gcw427/USBPhy-RW/README.md

# USBPhy-RW
The git repo contains three folders.

USBPhy-RW-Hardware folder is dongle harware pcb project including sch/layout.by AD17

USBPhy-RW-MCUFWSRC folder is dongle STM32 MCU firmware source project.by ARM MDK.

USBPhy-RW-DOTNETSRC folder is PC software source project.by Visual Studio2015/.NetFrameWork4
