gcw427/USBPhy-RW/USBPhy-RW-HardWare/USBPhyRW/sch.pdf

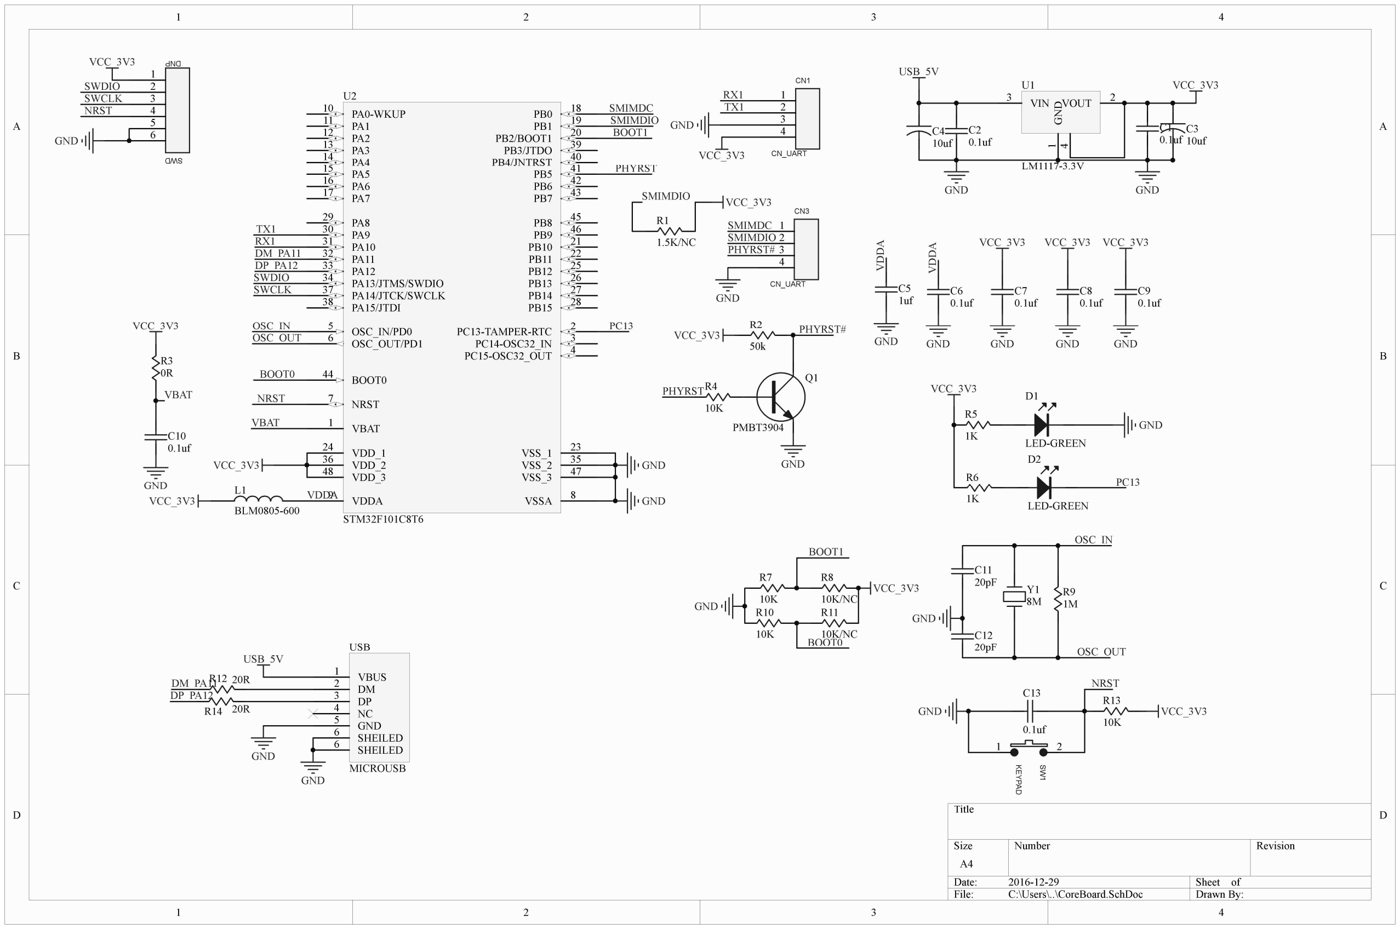
[picture p1: page 1]

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
Title
Size | Number | Revision
A4
Date: | 2016-12-29 | Sheet of
File: | C:\Users\..\CoreBoard.SchDoc | Drawn By:

BOOT0 44
NRST 7

OSC_IN/PD0 5
OSC_OUT/PD1 6

PA0-WKUP 10
PA1 11
PA2 12
PA3 13
PA4 14
PA5 15
PA6 16
PA7 17
PA8 29
PA9 30
PA10 31
PA11 32
PA12 33
PA13/JTMS/SWDIO 34
PA14/JTCK/SWCLK 37
PA15/JTDI 38

PB0 18
PB1 19
PB2/BOOT1 20
PB3/JTDO 39
PB4/JNTRST 40
PB5 41
PB6 42
PB7 43
PB8 45
PB9 46
PB10 21
PB11 22
PB12 25
PB13 26
PB14 27
PB15 28
PC13-TAMPER-RTC 2
PC14-OSC32_IN 3
PC15-OSC32_OUT 4

VBAT 1
VDD_1 24
VDD_2 36
VDD_3 48
VDDA 9

VSS_1 23
VSS_2 35
VSS_3 47
VSSA 8

U2

STM32F101C8T6

VIN 3 GND

1

VOUT 2 4

U1

LM1117-3.3V

USB_5V
VCC_3V3

C2
0.1uf

C4
10uf

C1
0.1uf

C3
10uf
GND | GND

C9
0.1uf

C8
0.1uf

C7
0.1uf

C6
0.1uf

VCC_3V3 VCC_3V3 VCC_3V3

GND | GND | GND | GND

D1

| | LED-GREEN
D2
| | LED-GREEN

Y1
8M

C11
20pF

C12
20pF

R5
1K
R6
1K

GND

VCC_3V3

GND

R9
1M
1 | 2 KEYPAD | SW1

C13
0.1uf

VCC_3V3

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
10K/NC
R10
10K

R11
10K/NC

VCC_3V3
GND

VBAT

NRST

BOOT0

OSC_IN
OSC_OUT

PC13

BOOT1

OSC_IN

OSC_OUT
NRST

PC13

BOOT0

BOOT1

C5
1uf
GND

VCC_3V3

R3
0R
VBAT
C10
0.1uf

VCC_3V3

GND

1
2
3
4

CN1

CN_UART

1
2
3
4
5

### 6 SWD

RX1
TX1
GND
VCC_3V3

RX1

TX1

VCC_3V3

GND

SWDIO
SWCLK

SWDIO
SWCLK
NRST

1
2
3
4

CN3

CN_UART

SMIMDC
SMIMDIO

SMIMDC
SMIMDIO

VBUS 1
DM 2
DP 3
NC 4
GND 5
SHEILED 6
SHEILED 6

USB

MICROUSB

GND

USB_5V

PHYRST

GND

Q1

PMBT3904

R4
10K

VCC_3V3

R2
50k

PHYRST

GND

PHYRST#

PHYRST#

R12 20R
R14 20R

DM_PA11
DP_PA12

DM_PA11
DP_PA12

GND

L1
BLM0805-600
VCC_3V3 | VDDA | VDDA | VDDA

R1
1.5K/NC

SMIMDIO VCC_3V3
