gcw427/USBPhy-RW/USBPhy-RW-HardWare/USBPhyRW/USBPhyRW.xlsx

Comment | Description | Designator | Footprint | LibRef | Quantity
0.1uf | Capacitor | C1, C2, C6, C7, C8, C9, C10, C13 | C0603 | CAP_1 | 8
10uf | Capacitor | C3, C4 | SMD-CT-2012 | CAPACITOR | 2
1uf | Capacitor | C5 | C0603 | CAP_1 | 1
20pF | Capacitor | C11, C12 | C0603 | CAP | 2
CN_UART |  | CN3 | CON_SIP4BOX_2MM | CON4 | 1 | 不贴
LED-GREEN |  | D1, D2 | LED-0805 | LED | 2
1.5K/NC |  | R1 | R0603 | RES1 | 1 | 不贴
50k/NC |  | R2 | R0603 | RES1 | 1 | 不贴
0R/NC |  | R3 | R0603 | RES1 | 1 | 不贴
0R |  | R4, R16 | R0603 | RES1, INDUCTOR1 | 2
1K |  | R5, R6 | R0603 | RES1 | 2
10K |  | R7, R10, R13 | R0603 | RES1 | 3
10K/NC |  | R8, R11 | R0603 | RES1 | 2
1M |  | R9 | R0603 | RES1 | 1
20R |  | R12, R14 | R0603 | RES1 | 2
4K7 |  | R15 | R0603 |  | 1
KEYPAD/NC |  | RST | SWITCH_T06B | PUSHBUTTON_TSKB-2L_0 | 1 | 不贴
DNP/NC |  | SWD | CON_SIP6BOX_2MM | CON6 | 1 | 不贴
LM1117-3.3V |  | U1 | SOT-223 | LM1117 | 1
STM32F101C8T6 | STM32 ARM-based 32-bit MCU with 64 Kbytes Flash, 48-pin LQFP, Industrial Temperature | U2 | LQFP48_N | STM32F101C8T6 | 1
CN_UART/NC |  | UART | CON_SIP4BOX_2MM | CON4 | 1 | 不贴
MICROUSB |  | USB | MICRO-USB/MK5P | MICROUSB | 1
8M | Crystal | Y1 | 5032-2P | CRYSTAL | 1
