gcw427/USBPhy-RW/USBPhy-RW-HardWare/USBPhyRW/USBPhyRW.pdf

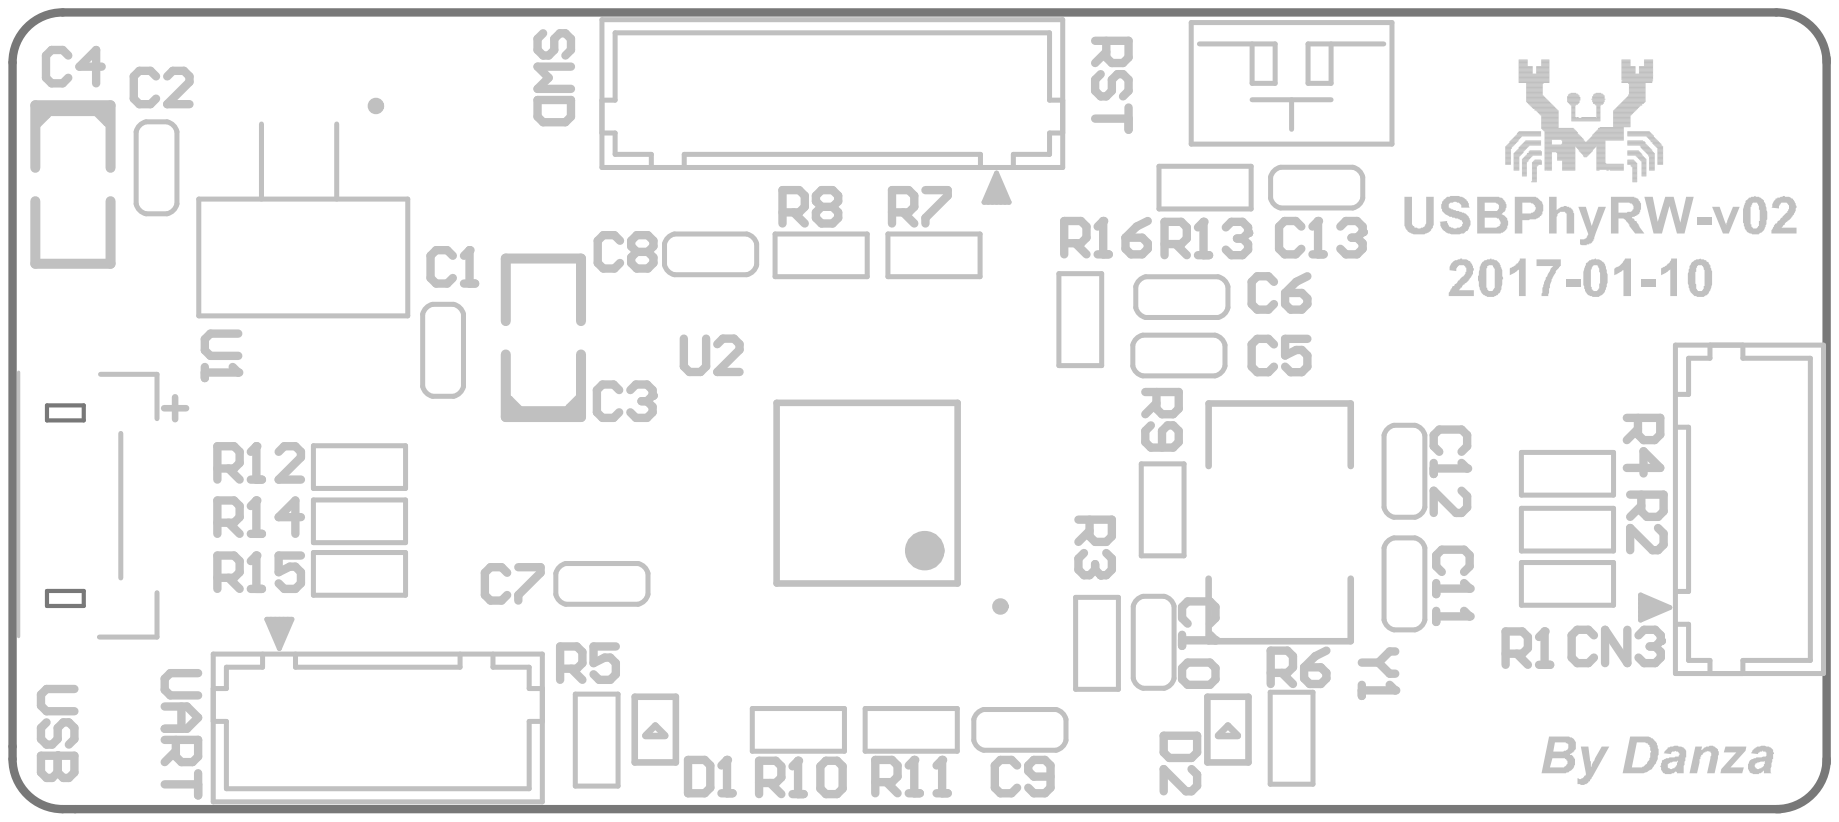
[picture p27: page 1]
