gcw427/USBPhy-RW/(list of files, drawings)

Other design files:
USBPhy-RW-HardWare/USBPhyRW/CoreBoard.SchDoc
USBPhy-RW-HardWare/USBPhyRW/USBPhyRW20180110.PcbDoc
USBPhy-RW-HardWare/USBPhyRW/USBPhyRW.PcbDoc
USBPhy-RW-HardWare/USBPhyRW/USBPhyRW.PrjPcb
USBPhy-RW-HardWare/USBPhyRW/USBPhyRW_1215.PcbDoc
