gcw427/USBPhy-RW/(commit log)

2018-01-30 Add USBPhy-RW Hardware schematic and layout project
    [CoreBoard.SchDoc, USBPhyRW.PcbDoc, USBPhyRW.PrjPcb, USBPhyRW.xlsx, USBPhyRW20180110.PcbDoc, USBPhyRW20180110.xlsx, USBPhyRW_1215.PcbDoc]
2018-06-21 Update STM32 MCU FW to support RTL8226 2.5G Phy series 20180621
    Update STM32 MCU FW to support RTL8226 2.5G Phy series 20180621
2018-07-02 Update Win STM32FW Source to support patchCodeFunction for 2.5G Phy Chip series 20180701
    Add sit bit and reset bit function for 2.5G phy Chip MDC/MIDO operation.
    Adjust MDC to 500KHz for 2.5GPhy RW to speed up the patch flow
    [main.c]
2018-07-14 Update Win PC tool to support RTL8226 2.5G Phy series 20180714
    Finetune patch thread sleep time to avoid STM32 USB bulkin interrupt confilcts.
